Alterego-42/BUPT-2026-EDC-SmartCar/(list of files, cad)

Other CAD files:
BUPT_ECar_2026/firmware/ecar_debug_mspm0g3507/ticlang/main.obj
BUPT_ECar_2026/firmware/ecar_debug_mspm0g3507/ticlang/imu.obj
BUPT_ECar_2026/firmware/ecar_debug_mspm0g3507/ticlang/ti_msp_dl_config.obj
BUPT_ECar_2026/firmware/ecar_debug_mspm0g3507/ticlang/line_follow.obj
BUPT_ECar_2026/firmware/ecar_debug_mspm0g3507/ticlang/startup_mspm0g350x_ticlang.obj
BUPT_ECar_2026/firmware/ecar_debug_mspm0g3507/ticlang/encoder.obj
BUPT_ECar_2026/firmware/ecar_debug_mspm0g3507/ticlang/timebase.obj
BUPT_ECar_2026/firmware/ecar_debug_mspm0g3507/ticlang/ui.obj
BUPT_ECar_2026/firmware/ecar_debug_mspm0g3507/ticlang/motor.obj
BUPT_ECar_2026/firmware/ecar_debug_mspm0g3507/ticlang/grayscale.obj
