Alterego-42/BUPT-2026-EDC-SmartCar/BUPT_ECar_2026/firmware/ecar_debug_mspm0g3507/src/encoder.h

#ifndef ENCODER_H
#define ENCODER_H

#include <stdint.h>

typedef struct {
    int32_t left_ticks;
    int32_t right_ticks;
    int32_t avg_ticks;
    int32_t distance_mm;
} encoder_snapshot_t;

void encoder_init(void);
void encoder_reset(void);
encoder_snapshot_t encoder_get(void);

#endif
