Alterego-42/BUPT-2026-EDC-SmartCar/BUPT_ECar_2026/firmware/ecar_debug_mspm0g3507/ticlang/syscfg/ti_msp_dl_config.c

/*
 * Copyright (c) 2023, Texas Instruments Incorporated
 * All rights reserved.
 *
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
 * *  Redistributions of source code must retain the above copyright
 *    notice, this list of conditions and the following disclaimer.
 *
 * *  Redistributions in binary form must reproduce the above copyright
 *    notice, this list of conditions and the following disclaimer in the
 *    documentation and/or other materials provided with the distribution.
 *
 * *  Neither the name of Texas Instruments Incorporated nor the names of
 *    its contributors may be used to endorse or promote products derived
 *    from this software without specific prior written permission.
 *
 * THIS SOFTWARE IS PROVIDED BY THE COPYRIGHT HOLDERS AND CONTRIBUTORS "AS IS"
 * AND ANY EXPRESS OR IMPLIED WARRANTIES, INCLUDING, BUT NOT LIMITED TO,
 * THE IMPLIED WARRANTIES OF MERCHANTABILITY AND FITNESS FOR A PARTICULAR
 * PURPOSE ARE DISCLAIMED. IN NO EVENT SHALL THE COPYRIGHT OWNER OR
 * CONTRIBUTORS BE LIABLE FOR ANY DIRECT, INDIRECT, INCIDENTAL, SPECIAL,
 * EXEMPLARY, OR CONSEQUENTIAL DAMAGES (INCLUDING, BUT NOT LIMITED TO,
 * PROCUREMENT OF SUBSTITUTE GOODS OR SERVICES; LOSS OF USE, DATA, OR PROFITS;
 * OR BUSINESS INTERRUPTION) HOWEVER CAUSED AND ON ANY THEORY OF LIABILITY,
 * WHETHER IN CONTRACT, STRICT LIABILITY, OR TORT (INCLUDING NEGLIGENCE OR
 * OTHERWISE) ARISING IN ANY WAY OUT OF THE USE OF THIS SOFTWARE,
 * EVEN IF ADVISED OF THE POSSIBILITY OF SUCH DAMAGE.
 */

/*
 *  ============ ti_msp_dl_config.c =============
 *  Configured MSPM0 DriverLib module definitions
 *
 *  DO NOT EDIT - This file is generated for the MSPM0G350X
 *  by the SysConfig tool.
 */

#include "ti_msp_dl_config.h"

/*
 *  ======== SYSCFG_DL_init ========
 *  Perform any initialization needed before using any board APIs
 */
SYSCONFIG_WEAK void SYSCFG_DL_init(void)
{
    SYSCFG_DL_initPower();
    SYSCFG_DL_GPIO_init();
    /* Module-Specific Initializations*/
    SYSCFG_DL_SYSCTL_init();
    SYSCFG_DL_PWM_MOTOR_init();
    SYSCFG_DL_UART_IMU_init();
    SYSCFG_DL_SYSTICK_init();
}



SYSCONFIG_WEAK void SYSCFG_DL_initPower(void)
{
    DL_GPIO_reset(GPIOA);
    DL_GPIO_reset(GPIOB);
    DL_TimerG_reset(PWM_MOTOR_INST);
    DL_UART_Main_reset(UART_IMU_INST);


    DL_GPIO_enablePower(GPIOA);
    DL_GPIO_enablePower(GPIOB);
    DL_TimerG_enablePower(PWM_MOTOR_INST);
    DL_UART_Main_enablePower(UART_IMU_INST);

    delay_cycles(POWER_STARTUP_DELAY);
}

SYSCONFIG_WEAK void SYSCFG_DL_GPIO_init(void)
{

    DL_GPIO_initPeripheralOutputFunction(GPIO_PWM_MOTOR_C0_IOMUX,GPIO_PWM_MOTOR_C0_IOMUX_FUNC);
    DL_GPIO_enableOutput(GPIO_PWM_MOTOR_C0_PORT, GPIO_PWM_MOTOR_C0_PIN);
    DL_GPIO_initPeripheralOutputFunction(GPIO_PWM_MOTOR_C1_IOMUX,GPIO_PWM_MOTOR_C1_IOMUX_FUNC);
    DL_GPIO_enableOutput(GPIO_PWM_MOTOR_C1_PORT, GPIO_PWM_MOTOR_C1_PIN);

    DL_GPIO_initPeripheralOutputFunction(
        GPIO_UART_IMU_IOMUX_TX, GPIO_UART_IMU_IOMUX_TX_FUNC);
    DL_GPIO_initPeripheralInputFunction(
        GPIO_UART_IMU_IOMUX_RX, GPIO_UART_IMU_IOMUX_RX_FUNC);

    DL_GPIO_initDigitalOutput(GPIO_MOTOR_L_IN1_IOMUX);

    DL_GPIO_initDigitalOutput(GPIO_MOTOR_L_IN2_IOMUX);

    DL_GPIO_initDigitalOutput(GPIO_MOTOR_R_IN1_IOMUX);

    DL_GPIO_initDigitalOutput(GPIO_MOTOR_R_IN2_IOMUX);

    DL_GPIO_initDigitalOutput(GPIO_MOTOR_STBY_IOMUX);

    DL_GPIO_initDigitalOutput(GPIO_GRAY_AD0_IOMUX);

    DL_GPIO_initDigitalOutput(GPIO_GRAY_AD1_IOMUX);

    DL_GPIO_initDigitalOutput(GPIO_GRAY_AD2_IOMUX);

    DL_GPIO_initDigitalInputFeatures(GPIO_GRAY_OUT_IOMUX,
		 DL_GPIO_INVERSION_DISABLE, DL_GPIO_RESISTOR_NONE,
		 DL_GPIO_HYSTERESIS_DISABLE, DL_GPIO_WAKEUP_DISABLE);

    DL_GPIO_initDigitalInputFeatures(GPIO_ENCODER_LR_A_IOMUX,
		 DL_GPIO_INVERSION_DISABLE, DL_GPIO_RESISTOR_NONE,
		 DL_GPIO_HYSTERESIS_DISABLE, DL_GPIO_WAKEUP_DISABLE);

    DL_GPIO_initDigitalInputFeatures(GPIO_ENCODER_LR_B_IOMUX,
		 DL_GPIO_INVERSION_DISABLE, DL_GPIO_RESISTOR_NONE,
		 DL_GPIO_HYSTERESIS_DISABLE, DL_GPIO_WAKEUP_DISABLE);

    DL_GPIO_initDigitalInputFeatures(GPIO_ENCODER_RR_A_IOMUX,
		 DL_GPIO_INVERSION_DISABLE, DL_GPIO_RESISTOR_NONE,
		 DL_GPIO_HYSTERESIS_DISABLE, DL_GPIO_WAKEUP_DISABLE);

    DL_GPIO_initDigitalInputFeatures(GPIO_ENCODER_RR_B_IOMUX,
		 DL_GPIO_INVERSION_DISABLE, DL_GPIO_RESISTOR_NONE,
		 DL_GPIO_HYSTERESIS_DISABLE, DL_GPIO_WAKEUP_DISABLE);

    DL_GPIO_initDigitalInputFeatures(GPIO_UI_START_KEY_IOMUX,
		 DL_GPIO_INVERSION_DISABLE, DL_GPIO_RESISTOR_PULL_UP,
		 DL_GPIO_HYSTERESIS_DISABLE, DL_GPIO_WAKEUP_DISABLE);

    DL_GPIO_initDigitalOutput(GPIO_UI_BEEP_IOMUX);

    DL_GPIO_initDigitalOutput(GPIO_UI_LED_R_IOMUX);

    DL_GPIO_initDigitalOutput(GPIO_UI_LED_G_IOMUX);

    DL_GPIO_clearPins(GPIOA, GPIO_MOTOR_L_IN1_PIN |
		GPIO_MOTOR_L_IN2_PIN |
		GPIO_GRAY_AD2_PIN |
		GPIO_UI_LED_G_PIN);
    DL_GPIO_enableOutput(GPIOA, GPIO_MOTOR_L_IN1_PIN |
		GPIO_MOTOR_L_IN2_PIN |
		GPIO_GRAY_AD2_PIN |
		GPIO_UI_LED_G_PIN);
    DL_GPIO_setUpperPinsPolarity(GPIOA, DL_GPIO_PIN_26_EDGE_RISE_FALL);
    DL_GPIO_clearInterruptStatus(GPIOA, GPIO_ENCODER_RR_A_PIN);
    DL_GPIO_enableInterrupt(GPIOA, GPIO_ENCODER_RR_A_PIN);
    DL_GPIO_clearPins(GPIOB, GPIO_MOTOR_R_IN1_PIN |
		GPIO_MOTOR_R_IN2_PIN |
		GPIO_MOTOR_STBY_PIN |
		GPIO_GRAY_AD0_PIN |
		GPIO_GRAY_AD1_PIN |
		GPIO_UI_LED_R_PIN);
    DL_GPIO_setPins(GPIOB, GPIO_UI_BEEP_PIN);
    DL_GPIO_enableOutput(GPIOB, GPIO_MOTOR_R_IN1_PIN |
		GPIO_MOTOR_R_IN2_PIN |
		GPIO_MOTOR_STBY_PIN |
		GPIO_GRAY_AD0_PIN |
		GPIO_GRAY_AD1_PIN |
		GPIO_UI_BEEP_PIN |
		GPIO_UI_LED_R_PIN);
    DL_GPIO_setUpperPinsPolarity(GPIOB, DL_GPIO_PIN_19_EDGE_RISE_FALL);
    DL_GPIO_clearInterruptStatus(GPIOB, GPIO_ENCODER_LR_A_PIN);
    DL_GPIO_enableInterrupt(GPIOB, GPIO_ENCODER_LR_A_PIN);

}



SYSCONFIG_WEAK void SYSCFG_DL_SYSCTL_init(void)
{

	//Low Power Mode is configured to be SLEEP0
    DL_SYSCTL_setBORThreshold(DL_SYSCTL_BOR_THRESHOLD_LEVEL_0);

    
	DL_SYSCTL_setSYSOSCFreq(DL_SYSCTL_SYSOSC_FREQ_BASE);
	/* Set default configuration */
	DL_SYSCTL_disableHFXT();
	DL_SYSCTL_disableSYSPLL();
    DL_SYSCTL_enableMFCLK();

}


/*
 * Timer clock configuration to be sourced by  / 1 (32000000 Hz)
 * timerClkFreq = (timerClkSrc / (timerClkDivRatio * (timerClkPrescale + 1)))
 *   32000000 Hz = 32000000 Hz / (1 * (0 + 1))
 */
static const DL_TimerG_ClockConfig gPWM_MOTORClockConfig = {
    .clockSel = DL_TIMER_CLOCK_BUSCLK,
    .divideRatio = DL_TIMER_CLOCK_DIVIDE_1,
    .prescale = 0U
};

static const DL_TimerG_PWMConfig gPWM_MOTORConfig = {
    .pwmMode = DL_TIMER_PWM_MODE_EDGE_ALIGN,
    .period = 1600,
    .isTimerWithFourCC = false,
    .startTimer = DL_TIMER_STOP,
};

SYSCONFIG_WEAK void SYSCFG_DL_PWM_MOTOR_init(void) {

    DL_TimerG_setClockConfig(
        PWM_MOTOR_INST, (DL_TimerG_ClockConfig *) &gPWM_MOTORClockConfig);

    DL_TimerG_initPWMMode(
        PWM_MOTOR_INST, (DL_TimerG_PWMConfig *) &gPWM_MOTORConfig);

    // Set Counter control to the smallest CC index being used
    DL_TimerG_setCounterControl(PWM_MOTOR_INST,DL_TIMER_CZC_CCCTL0_ZCOND,DL_TIMER_CAC_CCCTL0_ACOND,DL_TIMER_CLC_CCCTL0_LCOND);

    DL_TimerG_setCaptureCompareOutCtl(PWM_MOTOR_INST, DL_TIMER_CC_OCTL_INIT_VAL_LOW,
		DL_TIMER_CC_OCTL_INV_OUT_DISABLED, DL_TIMER_CC_OCTL_SRC_FUNCVAL,
		DL_TIMERG_CAPTURE_COMPARE_0_INDEX);

    DL_TimerG_setCaptCompUpdateMethod(PWM_MOTOR_INST, DL_TIMER_CC_UPDATE_METHOD_IMMEDIATE, DL_TIMERG_CAPTURE_COMPARE_0_INDEX);
    DL_TimerG_setCaptureCompareValue(PWM_MOTOR_INST, 1600, DL_TIMER_CC_0_INDEX);

    DL_TimerG_setCaptureCompareOutCtl(PWM_MOTOR_INST, DL_TIMER_CC_OCTL_INIT_VAL_LOW,
		DL_TIMER_CC_OCTL_INV_OUT_DISABLED, DL_TIMER_CC_OCTL_SRC_FUNCVAL,
		DL_TIMERG_CAPTURE_COMPARE_1_INDEX);

    DL_TimerG_setCaptCompUpdateMethod(PWM_MOTOR_INST, DL_TIMER_CC_UPDATE_METHOD_IMMEDIATE, DL_TIMERG_CAPTURE_COMPARE_1_INDEX);
    DL_TimerG_setCaptureCompareValue(PWM_MOTOR_INST, 1600, DL_TIMER_CC_1_INDEX);

    DL_TimerG_enableClock(PWM_MOTOR_INST);


    
    DL_TimerG_setCCPDirection(PWM_MOTOR_INST , DL_TIMER_CC0_OUTPUT | DL_TIMER_CC1_OUTPUT );


}


static const DL_UART_Main_ClockConfig gUART_IMUClockConfig = {
    .clockSel    = DL_UART_MAIN_CLOCK_MFCLK,
    .divideRatio = DL_UART_MAIN_CLOCK_DIVIDE_RATIO_1
};

static const DL_UART_Main_Config gUART_IMUConfig = {
    .mode        = DL_UART_MAIN_MODE_NORMAL,
    .direction   = DL_UART_MAIN_DIRECTION_TX_RX,
    .flowControl = DL_UART_MAIN_FLOW_CONTROL_NONE,
    .parity      = DL_UART_MAIN_PARITY_NONE,
    .wordLength  = DL_UART_MAIN_WORD_LENGTH_8_BITS,
    .stopBits    = DL_UART_MAIN_STOP_BITS_ONE
};

SYSCONFIG_WEAK void SYSCFG_DL_UART_IMU_init(void)
{
    DL_UART_Main_setClockConfig(UART_IMU_INST, (DL_UART_Main_ClockConfig *) &gUART_IMUClockConfig);

    DL_UART_Main_init(UART_IMU_INST, (DL_UART_Main_Config *) &gUART_IMUConfig);
    /*
     * Configure baud rate by setting oversampling and baud rate divisors.
     *  Target baud rate: 115200
     *  Actual baud rate: 115107.91
     */
    DL_UART_Main_setOversampling(UART_IMU_INST, DL_UART_OVERSAMPLING_RATE_16X);
    DL_UART_Main_setBaudRateDivisor(UART_IMU_INST, UART_IMU_IBRD_4_MHZ_115200_BAUD, UART_IMU_FBRD_4_MHZ_115200_BAUD);


    /* Configure Interrupts */
    DL_UART_Main_enableInterrupt(UART_IMU_INST,
                                 DL_UART_MAIN_INTERRUPT_RX);


    DL_UART_Main_enable(UART_IMU_INST);
}

SYSCONFIG_WEAK void SYSCFG_DL_SYSTICK_init(void)
{
    /*
     * Initializes the SysTick period to 1.00 ms,
     * enables the interrupt, and starts the SysTick Timer
     */
    DL_SYSTICK_config(32000);
}
