Alterego-42/BUPT-2026-EDC-SmartCar/BUPT_ECar_2026/firmware/ecar_debug_mspm0g3507/src/grayscale.h

#ifndef GRAYSCALE_H
#define GRAYSCALE_H

#include <stdbool.h>
#include <stdint.h>

typedef struct {
    uint8_t raw_mask;
    uint8_t black_mask;
    uint8_t black_count;
    int16_t error;
    bool line_seen;
} grayscale_sample_t;

void grayscale_init(void);
grayscale_sample_t grayscale_read(void);

#endif
