Alterego-42/BUPT-2026-EDC-SmartCar/(commit log)

2026-06-19 Add vendor materials with large file placeholders
2026-06-22 Add files via upload
    add_面包板接线架构
2026-06-24 Add files via upload
    面包板版本的接线与引脚分配
2026-06-24 Delete 北邮2026电赛小车_面包板接线方案_架构不变_V1.md
    旧版
2026-06-24 Add files via upload
    初版代码
2026-06-24 Add files via upload
    提交项目代码
2026-06-30 Update BUPT_ECar_2026 handoff state
    [encoder.obj, grayscale.obj, imu.obj, line_follow.obj, main.obj, motor.obj, startup_mspm0g350x_ticlang.obj, ti_msp_dl_config.obj]
